Ajimaru/QR204-Printer-Bridge/wiki/_Footer.md

---

<p align="center">
  <a href="https://github.com/Ajimaru/QR204-Printer-Bridge/wiki/Features">Features</a>
  · <a href="https://github.com/Ajimaru/QR204-Printer-Bridge/wiki/Hardware-and-Printing-Guide">Hardware &amp; Printing</a>
  · <a href="https://github.com/Ajimaru/QR204-Printer-Bridge/wiki/Assembly-Guide">Assembly Guide</a>
  · <a href="https://github.com/Ajimaru/QR204-Printer-Bridge/wiki/Setup-Guide">Setup Guide</a>
  · <a href="https://github.com/Ajimaru/QR204-Printer-Bridge/wiki/User-Guide">User Guide</a>
  · <a href="https://github.com/Ajimaru/QR204-Printer-Bridge/wiki/Development-Guide">Development Guide</a>
  · <a href="https://github.com/Ajimaru/QR204-Printer-Bridge">Repository</a>
  · <a href="https://github.com/Ajimaru/QR204-Printer-Bridge/blob/main/SECURITY.md">Security</a>
  · <a href="https://github.com/Ajimaru/QR204-Printer-Bridge/blob/main/LICENSE">MIT License</a>
</p>

<p align="center">
  <sub>QR204 Printer Bridge · ESC/POS network printer on an ESP32-C3</sub>
</p>
