Ajimaru/QR204-Printer-Bridge/wiki/_Sidebar.md

## Guides

- [Features](Features)
- [Hardware & Printing Guide](Hardware-and-Printing-Guide)
- [Assembly Guide](Assembly-Guide)
- [Setup Guide](Setup-Guide)
- [User Guide](User-Guide)
- [Development Guide](Development-Guide)

## Project

- [Home](Home)
- [Repository](https://github.com/Ajimaru/QR204-Printer-Bridge)
- [Security policy](https://github.com/Ajimaru/QR204-Printer-Bridge/blob/main/SECURITY.md)
- [License](https://github.com/Ajimaru/QR204-Printer-Bridge/blob/main/LICENSE)
