Ajimaru/QR204-Printer-Bridge/Thermal Printer Housing/Thermal_Printer_Housing_V1.stl

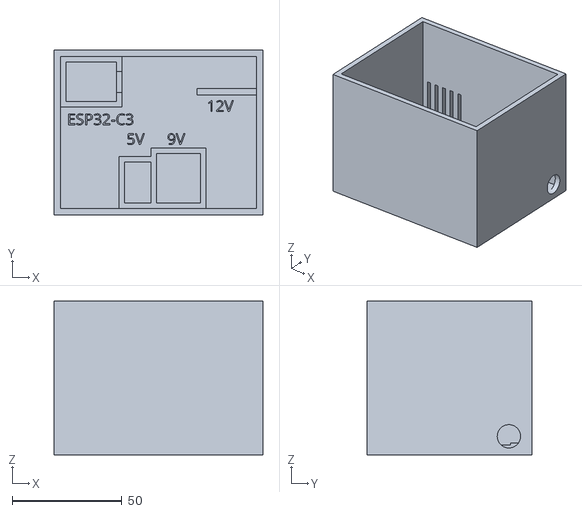
[picture p2: CAD file, 2026-11-01]
Thermal Printer Housing/Thermal_Printer_Housing_V1.stl
95.0 x 75.0 x 70.0
