Ajimaru/QR204-Printer-Bridge/(commit log)

2026-11-01 feat: add QR204 thermal printer bridge configuration and documentation
    - Created `thermal-printer.yaml` for ESP32-C3 configuration to serve as an ESC/POS network printer.
    - Added wiki documentation including Home, Sidebar, and Footer for QR204 Printer Bridge.
    - Included navigation templates for easy access to guides and project information.
    [Thermal_Printer_Housing_V1.stl, Thermal_Printer_Lid_V1.stl]
2026-11-01 feat: add install guide, config bundle and draft release workflow (#1)
    ## What
    - **Install guide.** The Setup Guide assumed a Home Assistant host that
    already had the sensor box's secrets. It now says what is needed, where
    to get the files, how to fill in `secrets.yaml` (new
    `esphome/secrets.yaml.example`) and how to flash with the Device Builder
    or the CLI. The README gets a short Installation section.
    - **Config bundle.** A new `release` workflow builds
    `QR204-Printer-Bridge-<version>.zip` (config, header, secrets template,
    `INSTALL.md`, housing STLs, `LICENSE`, `SECURITY.md`) plus a `.sha256`.
    - **Always a draft.** A tag `v*` or a bare version number creates a
    *draft* release with genera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
2026-11-01 ci: pin actions in validate and wiki-sync to commit SHAs (#2)
    Pins `actions/checkout` and `actions/setup-python` in `validate.yml` and `wiki-sync.yml` to the same commit SHAs `release.yml` already uses (checkout `9c091bb`, setup-python `5fda3b9`, both v7.0.0). No workflow uses a floating tag any more.
    ## Why
    `wiki-sync` holds a token with write access to the wiki. A moved tag would change what runs there without any change in this repository. With SHAs, an action update is an explicit, reviewable commit.
    ## Notes
    - This is a major-version step: checkout v4 → v7, setup-python v5 → v7. `release.yml` has already run with both, and `validate` runs with them on this PR.
    - `wiki-s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
2026-11-01 feat: report a firmware version and tie releases to it (#3)
    - `esphome.project` in `thermal-printer.yaml` (`ajimaru.qr204-printer-bridge`, version `0.1.0`). Home Assistant shows the version in the device info, and the device announces it over mDNS as `project_version`.
    - The `release` workflow reads the version from the YAML. On a tag it fails if the tag differs from it (`v0.1.0` or `0.1.0` against `"0.1.0"`). On pull requests it only checks that the version can be read.
    - Development Guide: the release order is now bump the version in a PR, merge, then tag.
    The config had no version, so a flashed bridge could not say which release it came from. Tying the tag to the file ke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
    [thermal-printer.yaml]
2026-11-06 Refresh documentation, update config, and improve versioning (#4)
    This pull request improves documentation, clarifies the release process,
    and enhances workflow reliability for the QR204 Printer Bridge project.
    The most significant changes include updating the release workflow to
    support version references, enhancing the README and hardware guide with
    images and clearer badges, and clarifying measured hardware behavior in
    the documentation.
    **Release workflow and versioning improvements:**
    - Updated the GitHub Actions release workflow to resolve `${version}`
    references in the `esphome.project.version` field by looking up the
    value in the `substitutions` block, ensuring the firmware version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
    [thermal-printer.yaml]
2026-11-06 docs(security): drop email contact, update log note, run validate on all PRs (#5)
    Includes a CI fix so this PR (and every docs-only PR) can pass the required checks.
    - SECURITY.md: remove the personal email from vulnerability reporting (GitHub private vulnerability reporting is enabled) and update the "Logs" note to the shipped `logger: level: INFO`.
    - CI: the required `esphome` and `docs` checks come from `validate.yml`, which was path-filtered to `esphome/**`. A docs/security-only PR never got its required checks and could not be merged. Run `validate` on every pull request; keep the path filter only for pushes to main.
